MarkusZVie/SmartUrbanFarming/SmartUrbanFarming/src/main/webapp/Image1.png

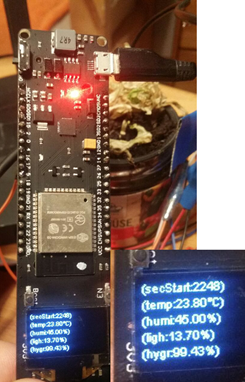
SmartUrbanFarming/src/main/webapp/Image1.png
