MarkusZVie/SmartUrbanFarming/Beta-Abgabe - SmartUrbanFarming.docx

# Beta-Abgabe - Smart Urban Farming

Beate Scheibel, Markus Zila

## Modelling Language

Der Teil “Modelling Language” war bereits bei der “Prototype”-Abgabe abgeschlossen. Hier wurde nichts mehr verändert.

## Physical Implementation

Der physische Teil der Implementation ist zu einem Großteil abgeschlossen. Das Farming Modul ist fertig gebaut und betriebsbereit. Ebenso kamen alle Sensoren zeitgerecht an und sind bereits in das Programm integriert. Es können Temperatur, Licht, Luftfeuchtigkeit und Erdfeuchtigkeit ausgelesen werden.

## Mechanisms and Algorithms

Das XML kann importiert und mithilfe eines selbst geschrieben Parsers ausgelesen werden. Die daraus generierten Daten werden in eine embedded apache derby Datenbank eingelesen.

Es existieren folgende tables, wobei die ersten drei der “Prototype”-Implementierung entsprechen.

- Location
- Farming_module
- Crop
- Sensordata: hier werden alle Sensordaten eingelesen und gespeichert. Primary key ist jeweils die Kombination aus farming_module-Name und timestamp (zum Zeitpunkt der Speicherung in die Datenbank). Bei jedem Einlesen in die Datenbank werden alle 4 Messwerte (Temperatur, Luftfeuchtigkeit, Licht, Erdfeuchtigkeit) gespeichert.

## Finalisierung des Arduino

Für das Rule-Based-System werden weiterhin die Überlegungen aus der “Prototype”-Abgabe angenommen. Derzeit werden Messdaten gesammelt um Richtwerte für die Rules zu erhalten.

Die Sensor Eingabe ist auf den Arduino implementiert. Er besitzt nun Zugang zu fier Sensoren.

Luftfeuchtigkeit und Temperatur werden digital ausgelesen und werden als float Prozent zahl ausgelesen. Die Bodenfeuchtigkeit und das Licht werden aus einen analogen Lesevorgang ermittelt. Der Lichtsensor misst den Wiederstand (je höher desto mehr Licht und umgekehrt) hier war nur eine Bestimmung von den minimal und maximal betrag notwendig um das Licht in Prozent zwischen minimal und maximal einzuordnen. Wir haben verzichtet das Licht in Lux zu messen, da eine Prozentuelle Bestimmung zwischen Dunkel und Sonnenlicht ausrechend ist.

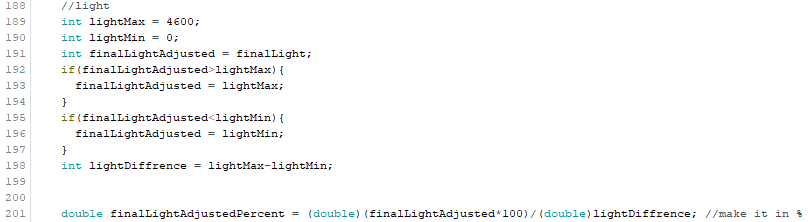
[picture p2: figure]

Die Bodenfeuchtigkeit wird invers gemessen. Je höher der Wiederstand desto geringer die Feuchtigkeit. Dies haben wir durch Beobachtung der analogen Werte festgestellt:

Setup:

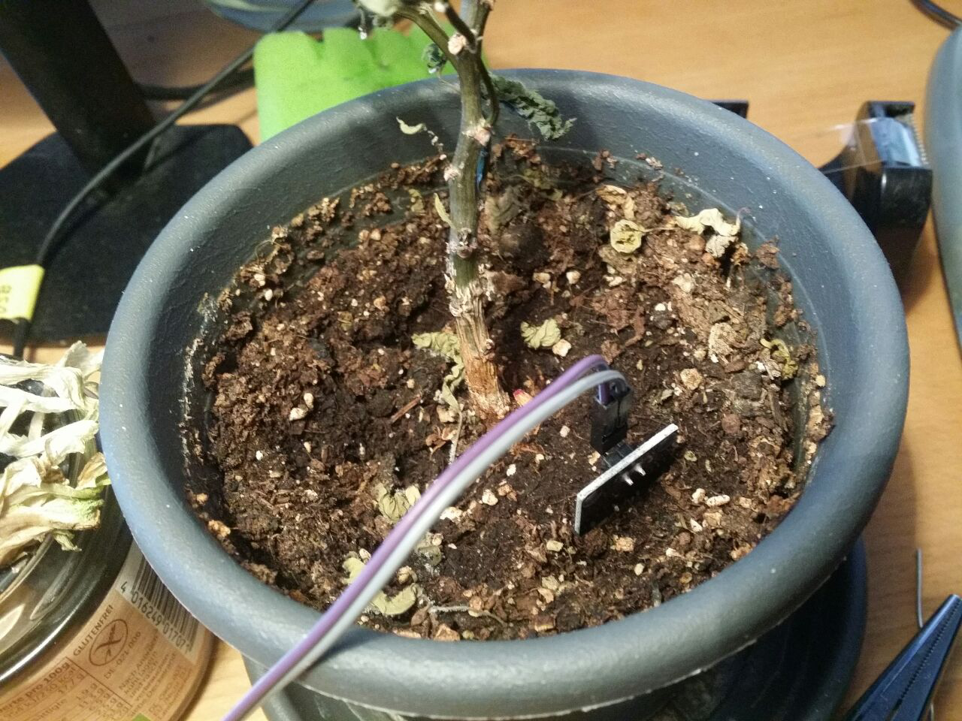
[picture p3: figure]
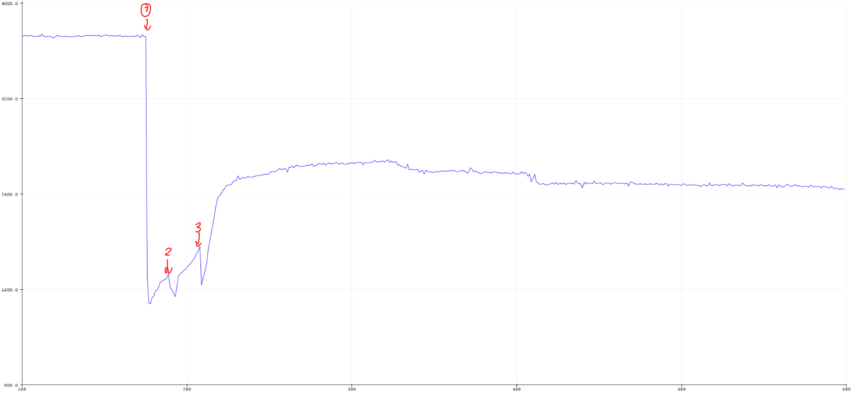
[picture p4: figure]

Punkt (1) War die erste Wässerung. Hier erkennt man deutlich, dass der wiederstand hinuntergeht. Bei den nächsten Wässerungen (2), (3) kommt der wert beinahe wieder auf das Niveau der ersten Wässerung. Dann Wird der Wiederstand schnell größer weil da das stehende Wasser im Topf versickert und nicht mehr an den Kontakten anliegt. Nach einiger Zeit merkt man, dass der Boden die Feuchtigkeit aufnimmt und der wiederstand langsam wieder sinkt.

Durch dieses Experiment haben wir auch den Minimal und Maximal betrag ermittelt. Um eine intuitive Form für die Bodenfeuchtigkeit zu bekommen haben wir den Messbereich um den Minimalbetrag nach unten verschoben, sodass der Minimalbetrag 0 ist, dann haben wir die Messung Inventiert und das Vorzeichen geändert, damit viel Bodenfeuchtigkeit auch ein hohes Ergebnis ist und dann haben wir noch den Wert Normalisiert, sodass der Wert zwischen 0 und 1 ist.

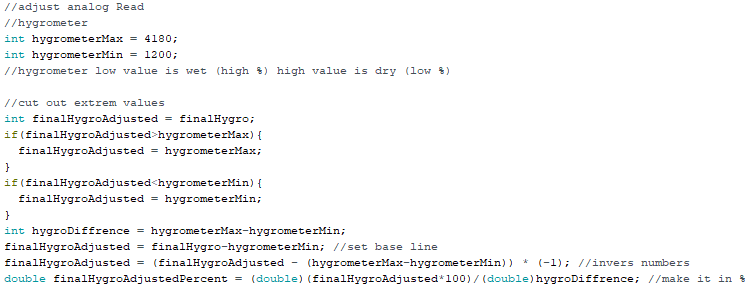
[picture p5: figure]

Da uns aufgefallen ist das die analogen Messungen stark fluktuieren haben wir öfter in der Sekunde gemessen und diese Messungen dann gemittelt. Das Ergebnis ist eine konstantere und verlässlichere Messung. Digitale Messungen dürfen nicht so schnell hintereinander gemacht werden, da sonst ein Fehler passiert.

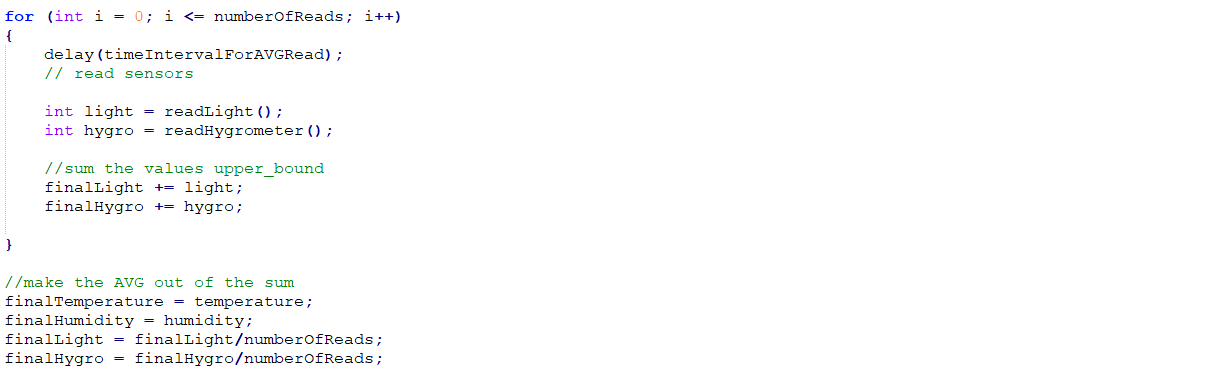
[picture p6: figure]

Den Lichtsensor mussten wir neu zusammenlöten, da dieser leider keine Gute Performance gebracht hat. Die analogen Messungen waren ständig außerhalb des Messungsbereichs und somit am Max oder Min Widerstand. Deshalb haben wir ein Potentiometer zu dem Lichtsensor gelötet und den Rest der Elektronik entfernt. Nun funktioniert die Bestimmung des Lichtlevels hervorragend.

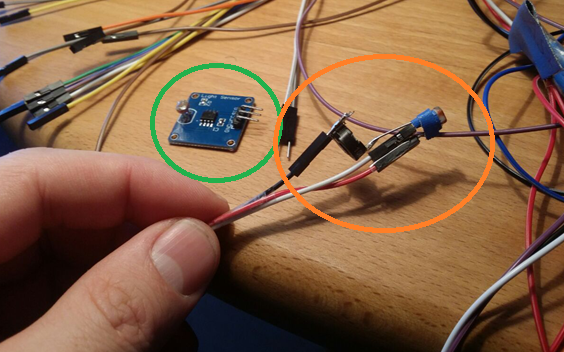
[picture p7: figure]
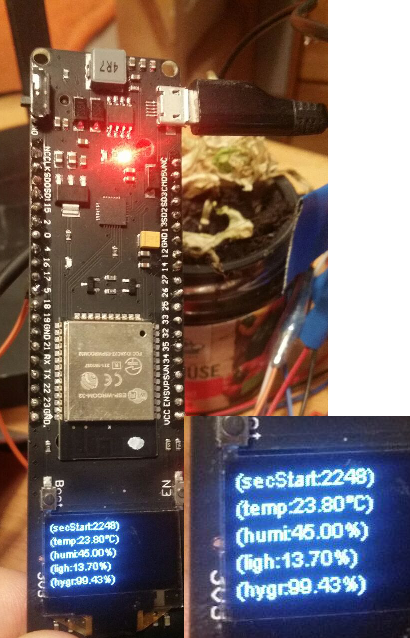
[picture p8: figure]

Grün (Original Sensor (Einstellung des Lichtniveau nicht möglich))
Orange (Eigenbau (Einstellung des Lichtniveau durch 10 KOhm Potentiometer möglich))

Die Sensor Daten werden am Display des ESP32 TTGO angezezeigt:

## Server weiterentwicklung

Und auch zum Server geschickt (ROT):

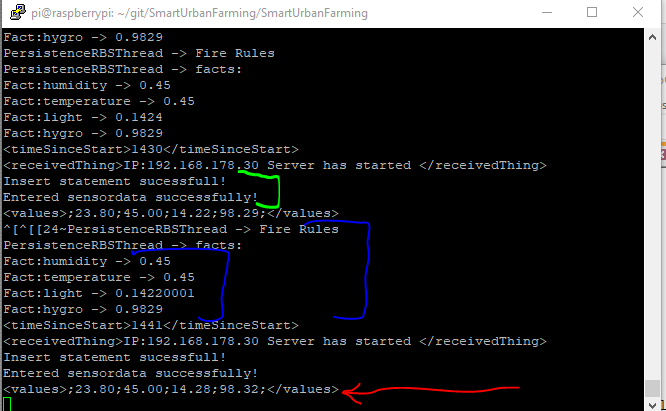
[picture p9: figure]

Dort werden diese Informationen in der Datenbank gespeichert (Grün).

Am Server gibt es eine Funktion, dass man die Sensordaten in ein CSV Datei speichern kann. Dies wird all 100 Sensormessungen gemacht. Weiter wird immer die neuste Messung in der Faktenbasis des RBS gespeichert (Blau). Die Regeln vom RBS werden durch einen Thread der beim Serverstad gestartet wird verwaltet. In der aktuellen Konfiguration werden alle 10 Sekunden alle Regeln des RBS gefeuert.

Die Sensordaten können auch in einer Java Server Page (JSP) eingesehen werden. Die Visualisierung haben wir mit CanvasJS.com einer Diagramm Visualisierung Software gemacht.

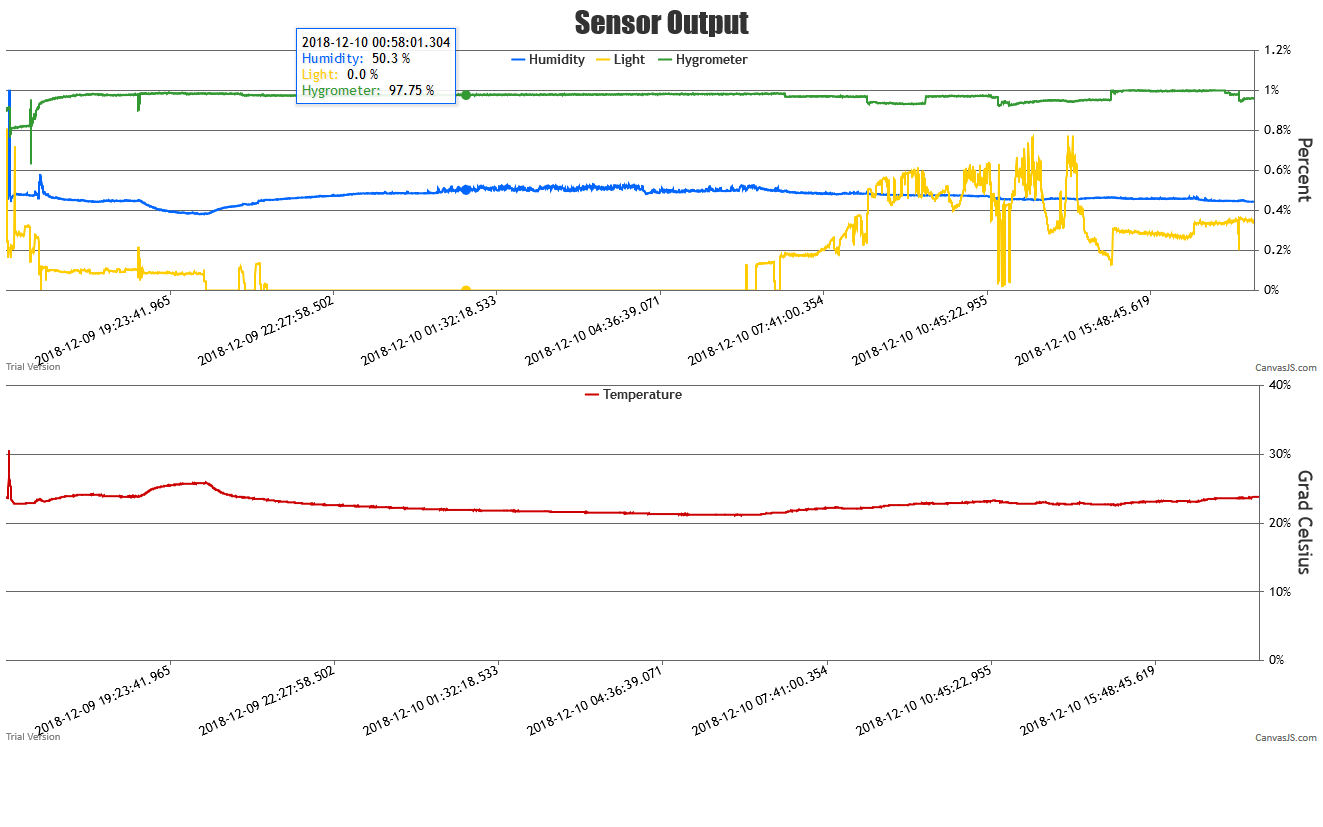
[picture p10: figure]

Wir haben die Bodenfeuchtigkeit, Luftfeuchtigkeit und Licht in ein Diagramm zusammengefügt, da alle Prozent darstellen. Die Temperatur mussten wir extra darstellen, da diese nicht zwischen normalisiert zwischen 0 und 1 ist.

Das RBS besitzt eine Regel, dass wenn das Licht unter 10 % ist, dass die Regel getriggert wird. Dies ist nur zu Test- und Demonstrations-Zwecke gedacht, da man ein niedriges Lichtlevel leicht herbeiführen kann. Diese ruft eine Funktion auf, dass eine Benachrichtigung an alle Hinterlegten Mailadressen gesendet wird. (Dies funktioniert derzeit noch nicht. Möglicherweise benötigt man dafür eine API key. Wie benutzen die GMail API von Google https://www.mkyong.com/java/javamail-api-sending-email-via-gmail-smtp-example/) . Mailadressen kann man auf einer JSP Seite des Server hinterlegen.

Die Mailadressen kann man hinzufügen (Blau) und entfernen (Rot).

## Next Steps

Für die Endabgabe muss das Rule-Based-System entwickelt werden (mithilfe von heuristischen Daten, die derzeit gewonnen werden). Ebenso soll das User-Interface noch ausgebaut werden um eine ansprechende Benutzer-Oberfläche zu gewährleisten.

Abschließend wird noch ein Video, dass die Funktionen des “Smart Urban Farming”-Produktes darstellt, produziert.
