MarkusZVie/SmartUrbanFarming/(commit log)

2018-10-28 add serial controller for arduino connection
2018-10-29 debug raspberry
2018-10-31 Server push ip address on Arduino + debug
2018-11-18 created tables + tested insert
2018-11-18 insert values from xml parser into database finished
2018-11-28 Arduino sensor lesebereit
2018-12-01 added sensordata table to database + method to add sensordata
2018-12-01 Arduino db connect
2018-12-03 write resultset to csv finished
    [hallo.csv]
2018-12-03 csv things
    [csvExport.csv]
2018-12-09 number normalised
    [csvExport.csv]
2018-12-09 online chart
    [csvExport.csv]
2018-12-09 update Max Hygro
    [csvExport.csv]
2018-12-10 fill in data
    [csvExport.csv]
2018-12-10 make testrule and stuff
    [csvExport.csv]
2019-01-09 add light facts
    [csvExport.csv, lightFunktionTest.csv]
2019-01-16 frontend weiter
    [csvExport.csv]
2019-01-19 long term - temp rule done
    [hallo.csv]
2019-01-19 temperature rules finished
2019-01-20 add sensor adjusted
    [csvExport.csv]
2019-01-20 ui update
    [csvExport.csv]
2019-01-20 add mailin funktionality
    [csvExport.csv]
